marekw1986/HD64180_computer/code/CPMBootloader/README.md

# POLON 7880

This is code of TinyBsic for final version of POLON 7880, build on PCBs.
