marekw1986/HD64180_computer/hardware/cpu_board/untitled.brd

## EAGLE design hardware/cpu_board/untitled.brd (2026-01-10)

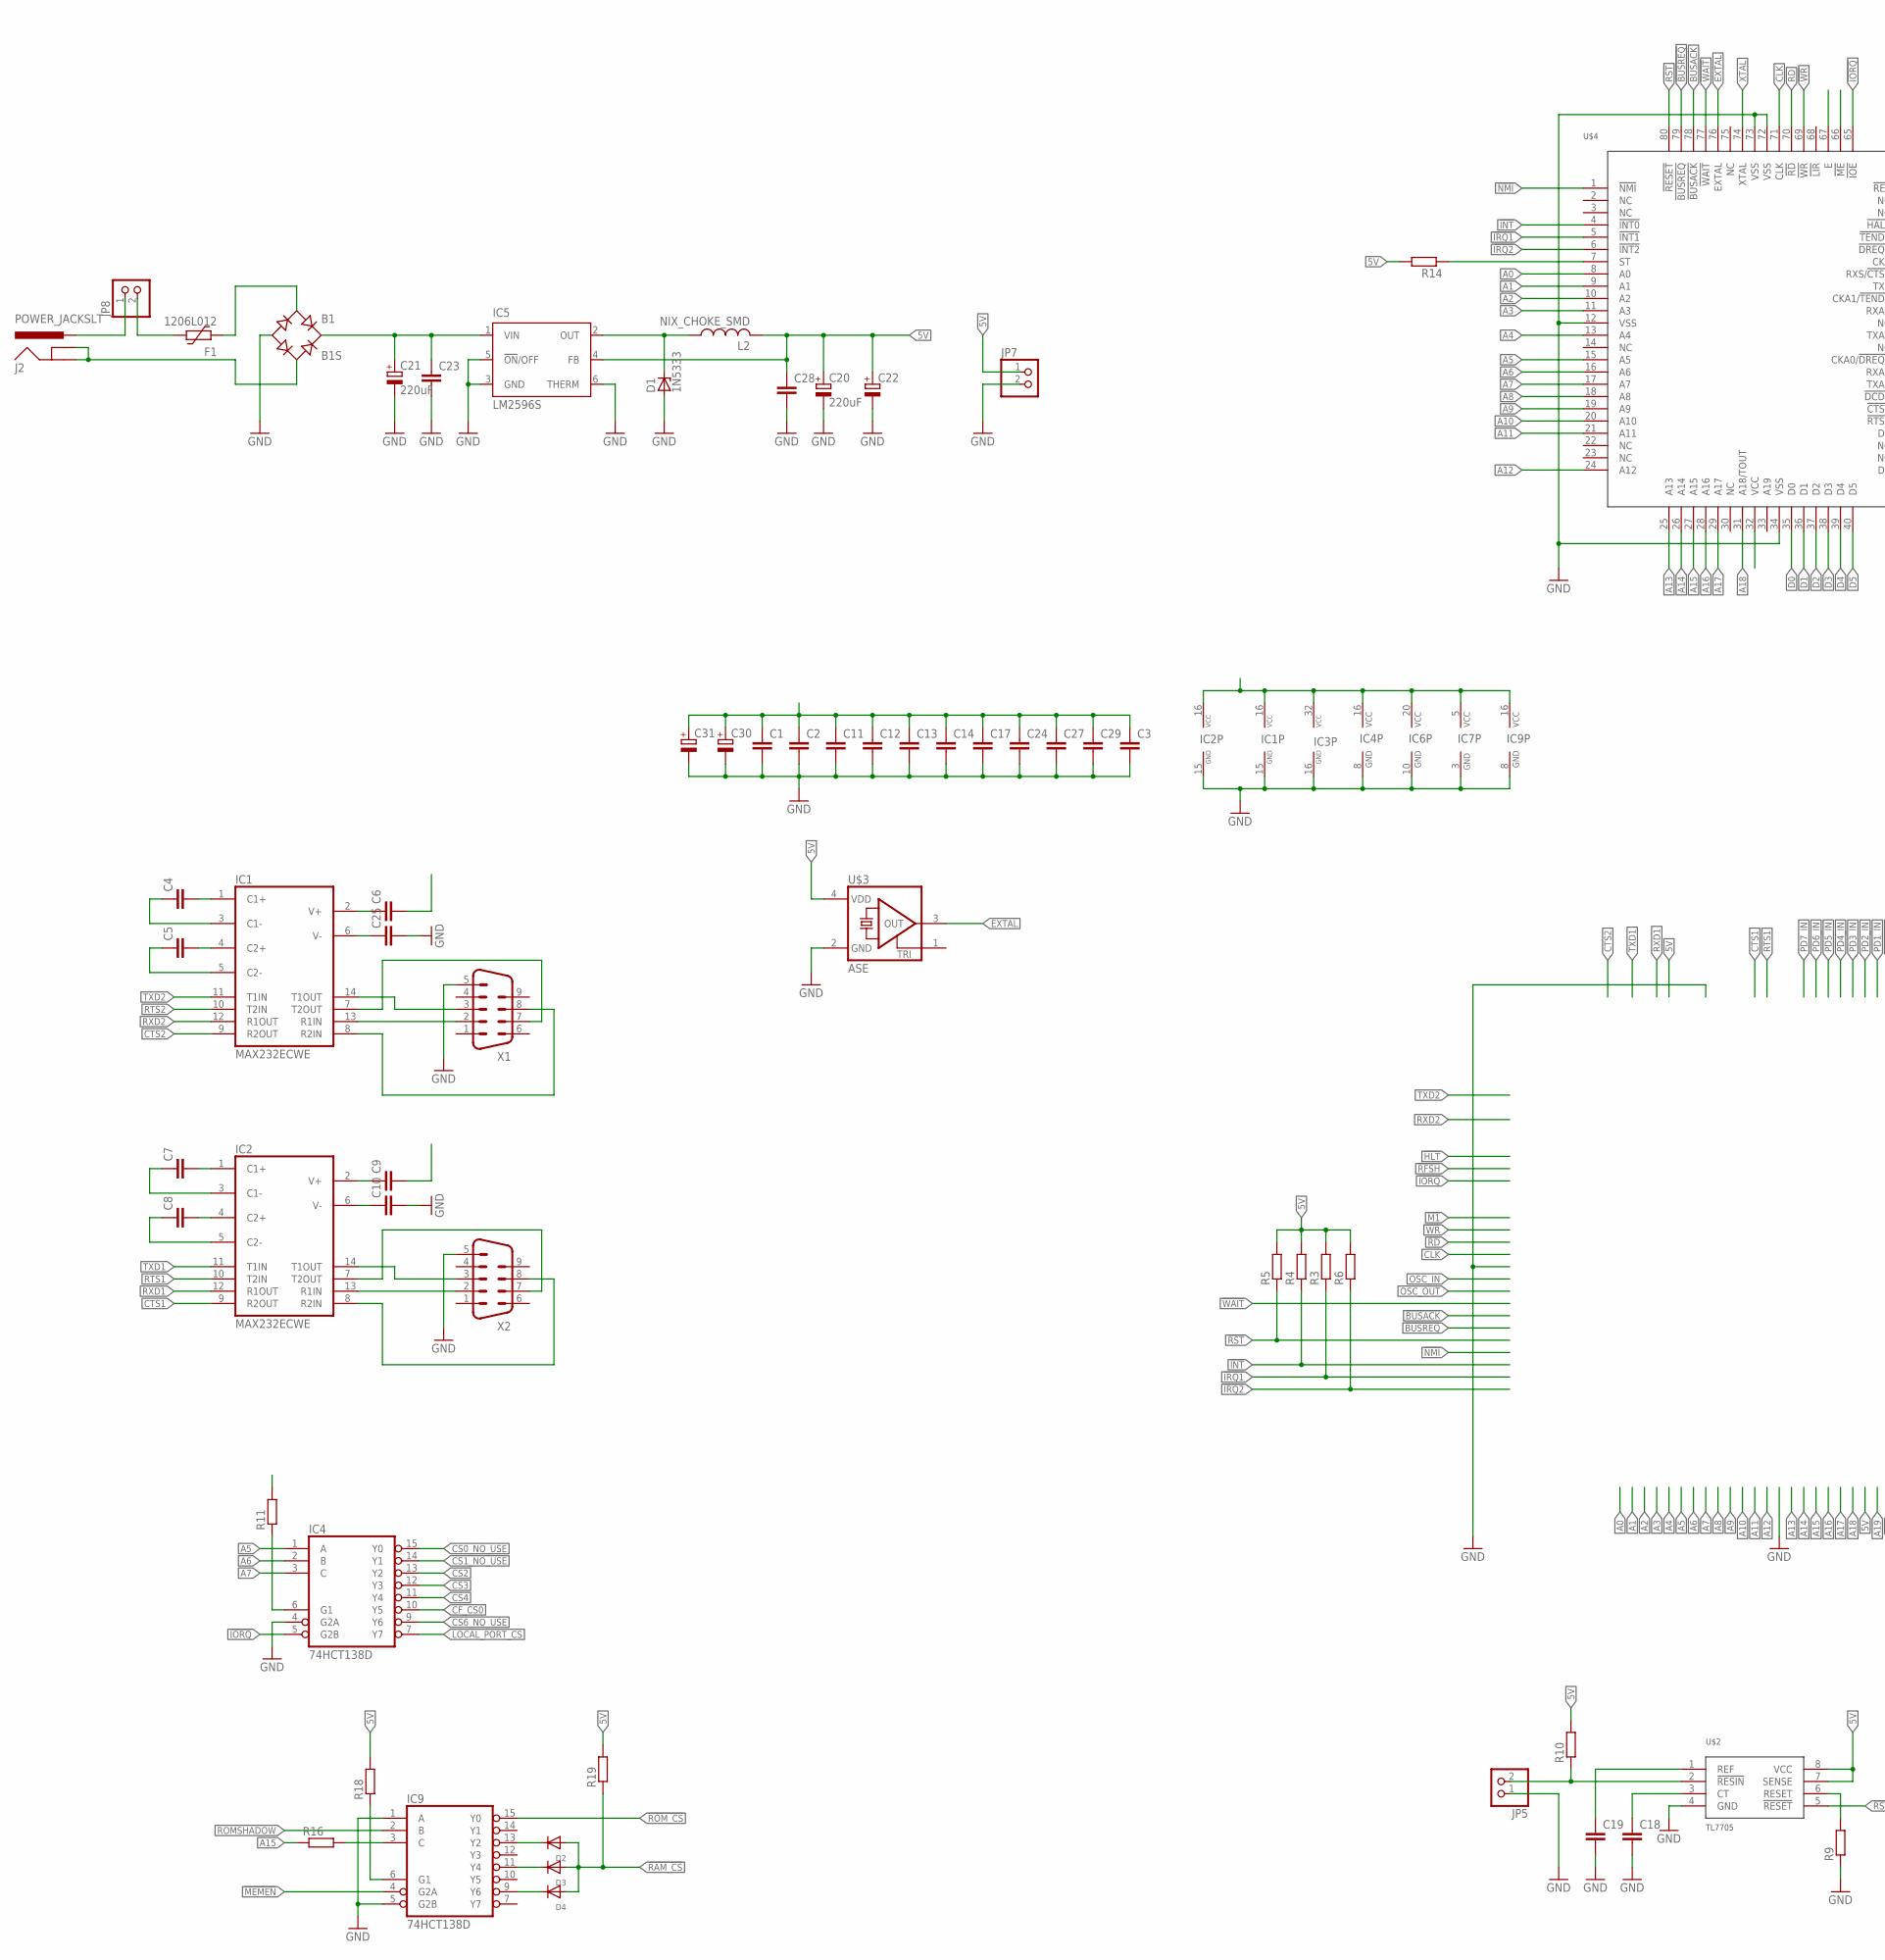
[picture p1: schematic untitled.sch, part in row 1, column 1]

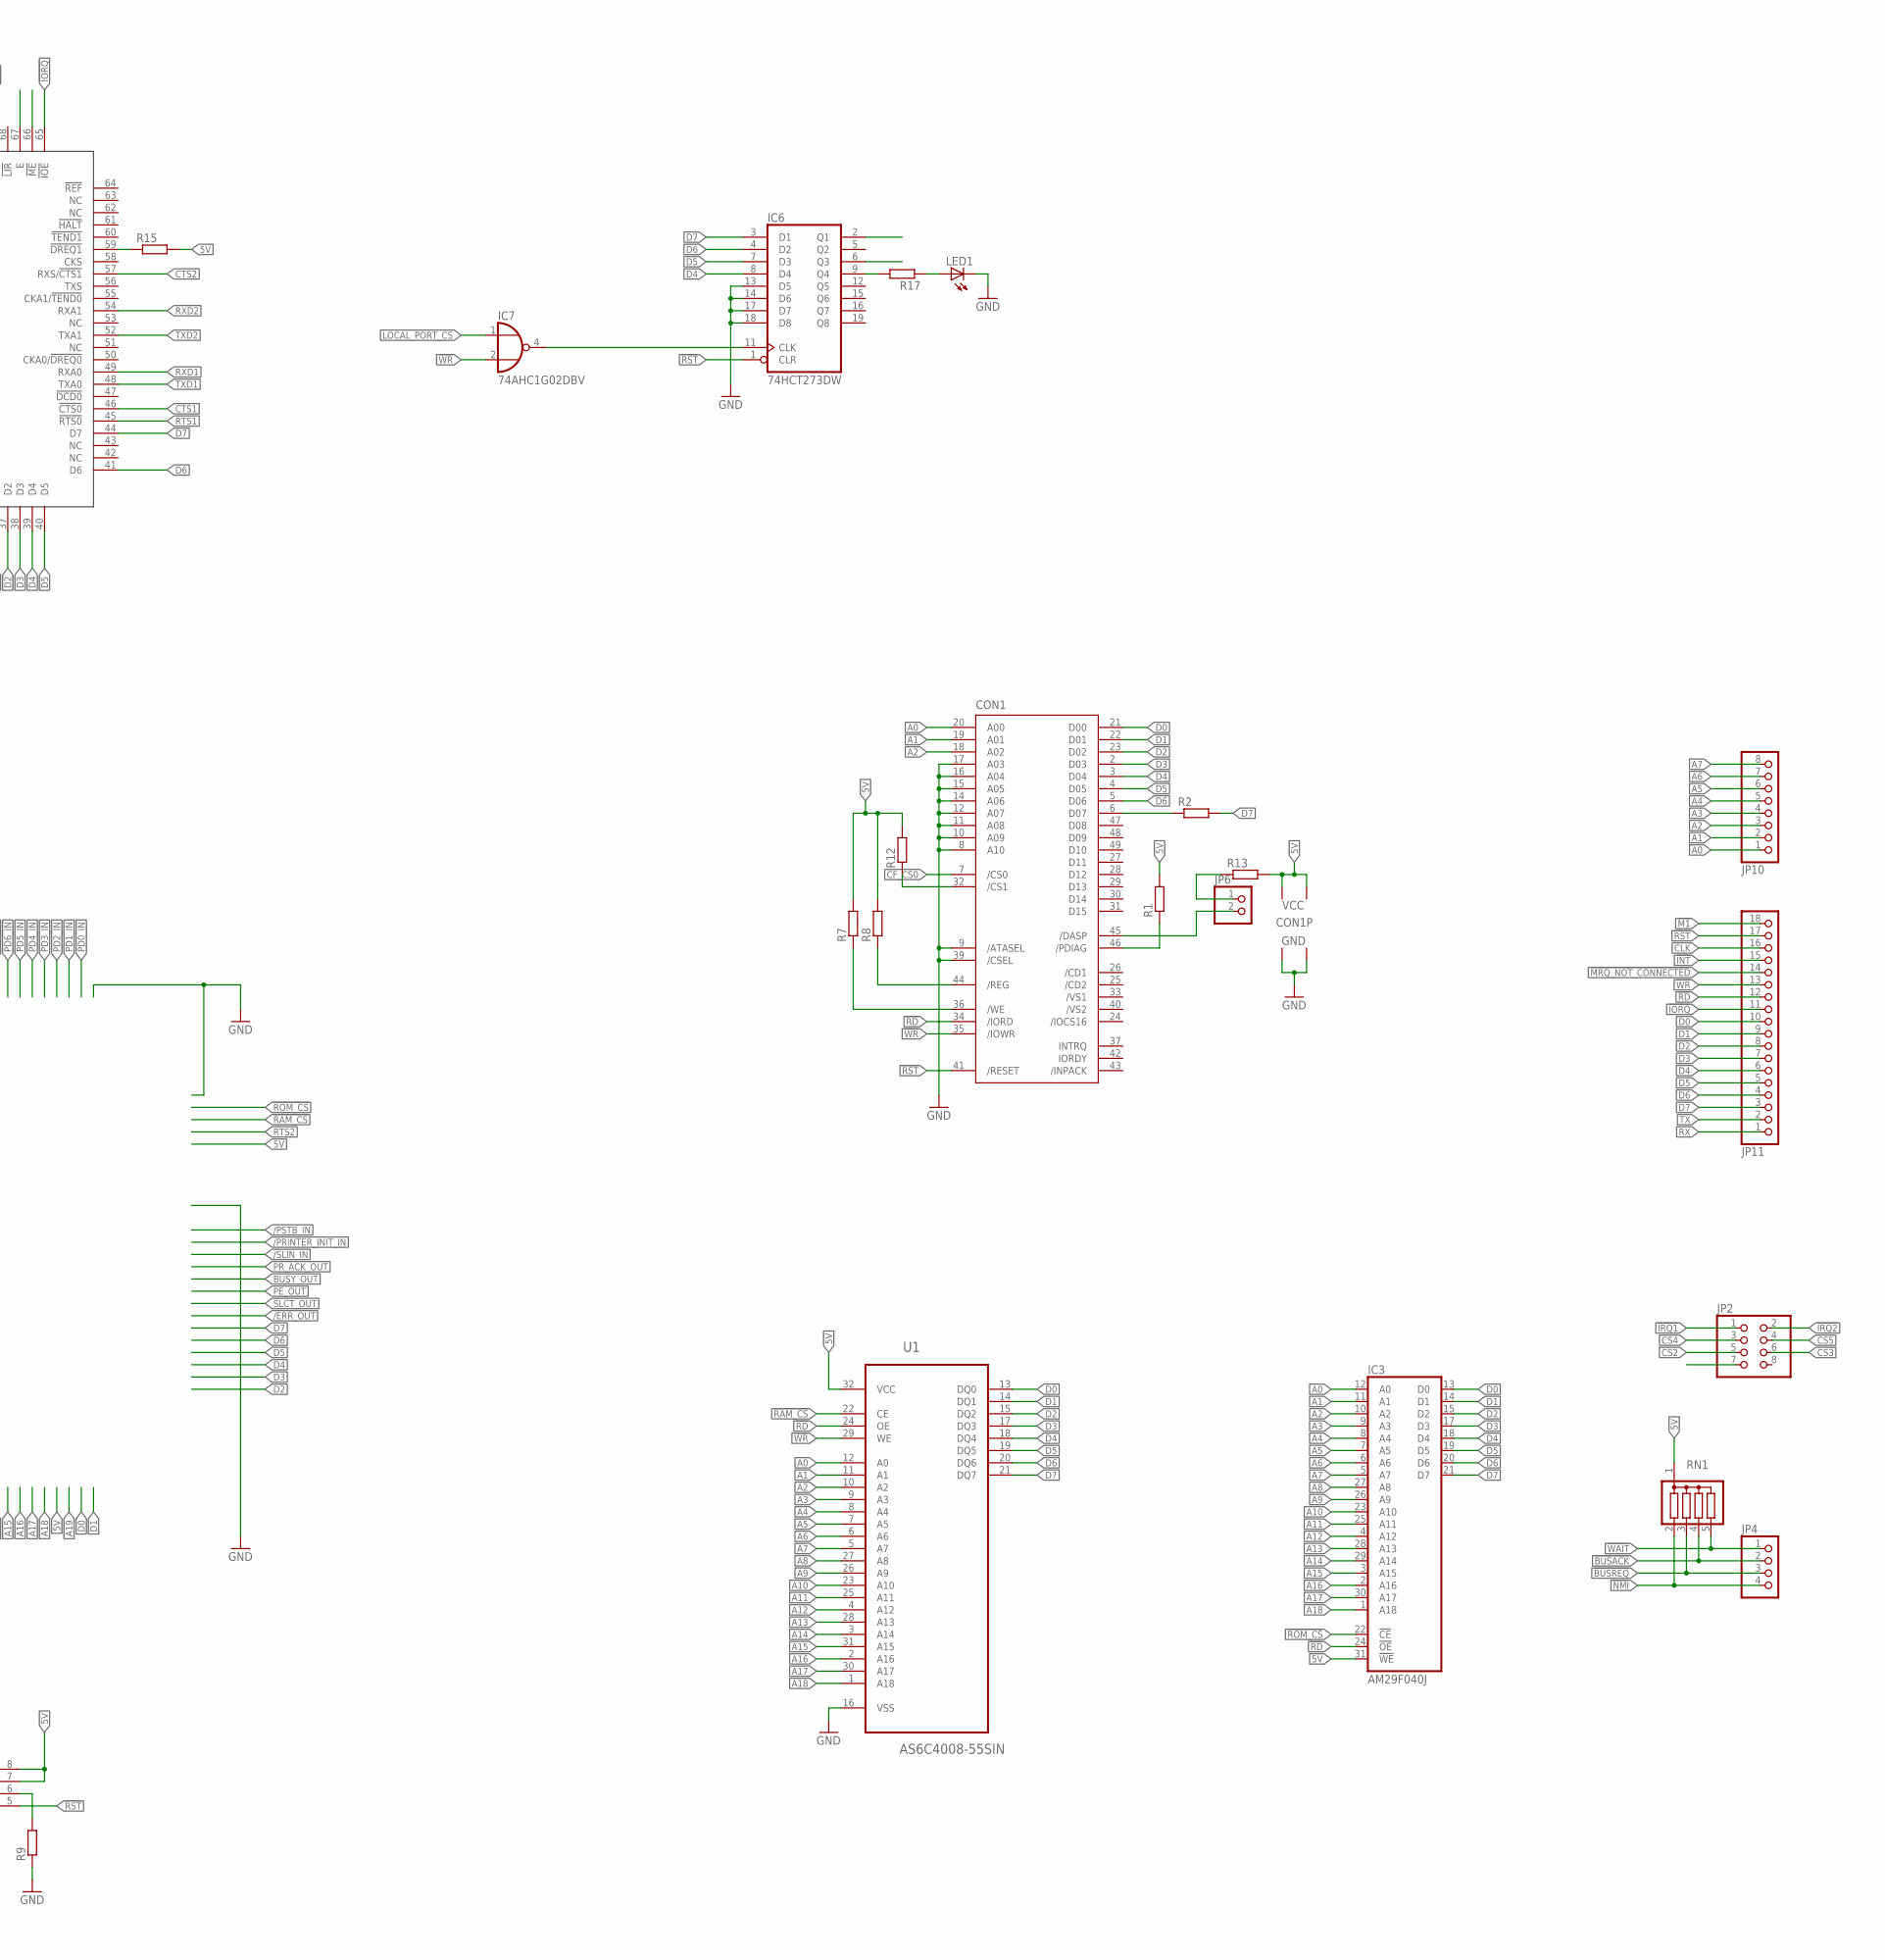
[picture p2: schematic untitled.sch, part in row 1, column 2]

Parts:
B1: B1S; MBS
C1, C2, C3, C4, C5, C6, C7, C8, C9, C10, C11, C12, C14, C17, C18, C19, C23, C24, C25, C27, C28, C29: C-EUC0603; C0603
C13: C-EUC0402; C0402
C20, C21: 220uF; 153CLV-0810
C22: CPOL-EUSMCC; SMC_C
C30, C31: CPOL-EUSMCB; SMC_B
CON1: CF-CARD-IDE_MODE; MI20-50PD-SF
D1: 1N5333; C1702-15
D2, D3, D4: DIODESOD-323; SOD-323
F1: 1206L012; 1206L
IC1, IC2: MAX232ECWE; SO16L
IC3: AM29F040J; PLCC32R
IC4, IC9: 74HCT138D; SO16
IC5: LM2596S; TO263-5
IC6: 74HCT273DW; SO20W
IC7: 74AHC1G02DBV; SOT23-5
J2: POWER_JACKSLT; POWER_JACK_SLOT
JP2: PINHD-2X4; 2X04
JP4: PINHD-1X4; 1X04
JP5, JP6, JP7, JP8: PINHD-1X2; 1X02
JP10: PINHD-1X8; 1X08
JP11: PINHD-1X18; 1X18
L2: NIX_CHOKE_SMD
LED1: LEDCHIP-LED0603; CHIP-LED0603
R1, R2, R7, R8, R9, R11, R12, R13, R15, R16, R17, R18, R19: R-EU_R0603; R0603
R3, R4, R6: R-EU_R0402; R0402
R5: R-EU_R1206; R1206
R10: R-EU_M1206; M1206
R14: R-EU_0204/5; 0204/5
RN1: G04R; SIL5
U1: AS6C4008-55SIN; SOIC127P1407X299-32N
U$2: TL7705; SOIC8
U$3: ASE
U$4: HD64180QFP80_; QFP80
X1, X2: M09HP

Connections:
5V: C1.1, C2.1, C3.1, C6.2, C9.2, C11.1, C12.1, C13.1, C14.1, C17.1, C20.+, C22.+, C24.1, C27.1, C28.1, C29.1, C30.+, C31.+, CON1.13 (VCC2), CON1.38 (VCC1), IC1.16 (VCC), IC2.16 (VCC), IC3.31 (!WE), IC3.32 (VCC), IC4.16 (VCC), IC5.4 (FB), IC6.20 (VCC), IC7.5 (VCC), IC9.16 (VCC), JP7.1, L2.P$2 (2), R1.2, R3.2, R4.2, R5.2, R6.2, R7.2, R8.2, R10.2, R11.2, R12.2, R13.2, R14.2, R15.2, R18.2, R19.2, RN1.1, U1.32 (VCC), U$2.7 (SENSE), U$2.8 (VCC), U$3.4 (VDD), U$4.32 (VCC)
!BUSACK: JP4.2, RN1.4, U$4.78 (!BUSACK)
!BUSREQ: JP4.3, RN1.3, U$4.79 (!BUSREQ)
!INT: JP11.15, R4.1, U$4.4 (!INT0)
!IORQ: IC4.5 (G2B), JP11.11, U$4.65 (!IOE)
!IRQ1: JP2.1, R3.1, U$4.5 (!INT1)
!IRQ2: JP2.2, R6.1, U$4.6 (!INT2)
!M1: JP11.18
!MEMEN: IC9.4 (G2A), U$4.66 (!ME)
!MRQ_NOT_CONNECTED: JP11.14
!NMI: JP4.4, RN1.2, U$4.1 (!NMI)
!RAM_CS: D2.A, D3.A, D4.A, R19.1, U1.22 (CE)
!RD: CON1.34 (/IORD), IC3.24 (!OE), JP11.12, U1.24 (OE), U$4.70 (!RD)
!ROM_CS: IC3.22 (!CE), IC9.15 (Y0)
!RST: CON1.41 (/RESET), IC6.1 (CLR), JP11.17, R5.1, U$2.5 (!RESET), U$4.80 (!RESET)
!WAIT: JP4.1, RN1.5, U$4.77 (!WAIT)
!WR: CON1.35 (/IOWR), IC7.2 (I1), JP11.13, U1.29 (WE), U$4.69 (!WR)
A0: CON1.20 (A00), IC3.12 (A0), JP10.1, U1.12 (A0), U$4.8 (A0)
A1: CON1.19 (A01), IC3.11 (A1), JP10.2, U1.11 (A1), U$4.9 (A1)
A2: CON1.18 (A02), IC3.10 (A2), JP10.3, U1.10 (A2), U$4.10 (A2)
A3: IC3.9 (A3), JP10.4, U1.9 (A3), U$4.11 (A3)
A4: IC3.8 (A4), JP10.5, U1.8 (A4), U$4.13 (A4)
A5: IC3.7 (A5), IC4.1 (A), JP10.6, U1.7 (A5), U$4.15 (A5)
A6: IC3.6 (A6), IC4.2 (B), JP10.7, U1.6 (A6), U$4.16 (A6)
A7: IC3.5 (A7), IC4.3 (C), JP10.8, U1.5 (A7), U$4.17 (A7)
A8: IC3.27 (A8), U1.27 (A8), U$4.18 (A8)
A9: IC3.26 (A9), U1.26 (A9), U$4.19 (A9)
A10: IC3.23 (A10), U1.23 (A10), U$4.20 (A10)
A11: IC3.25 (A11), U1.25 (A11), U$4.21 (A11)
A12: IC3.4 (A12), U1.4 (A12), U$4.24 (A12)
A13: IC3.28 (A13), U1.28 (A13), U$4.25 (A13)
A14: IC3.29 (A14), U1.3 (A14), U$4.26 (A14)
A15: IC3.3 (A15), R16.1, U1.31 (A15), U$4.27 (A15)
A16: IC3.2 (A16), U1.2 (A16), U$4.28 (A16)
A17: IC3.30 (A17), U1.30 (A17), U$4.29 (A17)
A18: IC3.1 (A18), U1.1 (A18), U$4.31 (A18/TOUT)
CF_CS0: CON1.7 (/CS0), IC4.10 (Y5)
CLK: JP11.16, U$4.71 (CLK)
CS0_NO_USE: IC4.15 (Y0)
CS1_NO_USE: IC4.14 (Y1)
CS2: IC4.13 (Y2), JP2.5
CS3: IC4.12 (Y3), JP2.6
CS4: IC4.11 (Y4), JP2.3
CS5: JP2.4
CS6_NO_USE: IC4.9 (Y6)
CTS1: IC2.9 (R2OUT), U$4.46 (!CTS0)
CTS2: IC1.9 (R2OUT), U$4.57 (RXS/!CTS1)
D0: CON1.21 (D00), IC3.13 (D0), JP11.10, U1.13 (DQ0), U$4.35 (D0)
D1: CON1.22 (D01), IC3.14 (D1), JP11.9, U1.14 (DQ1), U$4.36 (D1)
D2: CON1.23 (D02), IC3.15 (D2), JP11.8, U1.15 (DQ2), U$4.37 (D2)
D3: CON1.2 (D03), IC3.17 (D3), JP11.7, U1.17 (DQ3), U$4.38 (D3)
D4: CON1.3 (D04), IC3.18 (D4), IC6.8 (D4), JP11.6, U1.18 (DQ4), U$4.39 (D4)
D5: CON1.4 (D05), IC3.19 (D5), IC6.7 (D3), JP11.5, U1.19 (DQ5), U$4.40 (D5)
D6: CON1.5 (D06), IC3.20 (D6), IC6.4 (D2), JP11.4, U1.20 (DQ6), U$4.41 (D6)
D7: IC3.21 (D7), IC6.3 (D1), JP11.3, R2.2, U1.21 (DQ7), U$4.44 (D7)
E: JP2.7, U$4.67 (E)
EXTAL: U$3.3 (OUT), U$4.76 (EXTAL)
GND: B1.-, C1.2, C2.2, C3.2, C10.2, C11.2, C12.2, C13.2, C14.2, C17.2, C18.2, C19.2, C20.-, C21.-, C22.-, C23.2, C24.2, C25.2, C27.2, C28.2, C29.2, C30.-, C31.-, CON1.1 (GND1), CON1.8 (A10), CON1.9 (/ATASEL), CON1.10 (A09), CON1.11 (A08), CON1.12 (A07), CON1.14 (A06), CON1.15 (A05), CON1.16 (A04), CON1.17 (A03), CON1.39 (/CSEL), CON1.50 (GND2), D1.A, IC1.15 (GND), IC2.15 (GND), IC3.16 (GND), IC4.4 (G2A), IC4.8 (GND), IC5.3 (GND), IC5.5 (!ON!/OFF), IC5.6 (THERM), IC6.10 (GND), IC6.13 (D5), IC6.14 (D6), IC6.17 (D7), IC6.18 (D8), IC7.3 (GND), IC9.1 (A), IC9.5 (G2B), IC9.8 (GND), JP5.1, JP7.2, LED1.C, R9.1, U1.16 (VSS), U$2.4 (GND), U$3.2 (GND), U$4.12 (VSS), U$4.34 (VSS), U$4.72 (VSS), U$4.73 (VSS), X1.5, X2.5
LOCAL_PORT_CS: IC4.7 (Y7), IC7.1 (I0)
unnamed: IC2.7 (T2OUT), X2.7
unnamed: C7.2, IC2.1 (C1+)
unnamed: C8.2, IC2.4 (C2+)
unnamed: C8.1, IC2.5 (C2-)
unnamed: C7.1, IC2.3 (C1-)
unnamed: C9.1, IC2.2 (V+)
unnamed: IC1.7 (T2OUT), X1.7
unnamed: IC1.13 (R1IN), X1.2
unnamed: C4.2, IC1.1 (C1+)
unnamed: C5.2, IC1.4 (C2+)
unnamed: C5.1, IC1.5 (C2-)
unnamed: C4.1, IC1.3 (C1-)
unnamed: C6.1, IC1.2 (V+)
unnamed: C25.1, IC1.6 (V-)
unnamed: IC2.13 (R1IN), X2.2
unnamed: IC2.14 (T1OUT), X2.3
unnamed: IC2.8 (R2IN), X2.8
unnamed: IC1.14 (T1OUT), X1.3
unnamed: C10.1, IC2.6 (V-)
unnamed: J2.PWR, JP8.1
unnamed: B1.AC1, F1.2
unnamed: B1.+, C21.+, C23.1, IC5.1 (VIN)
unnamed: D1.C, IC5.2 (OUT), L2.P$1 (1)
unnamed: B1.AC2, J2.GND@1 (GNDBREAK), J2.GND@2 (GND)
unnamed: R15.1, U$4.59 (!DREQ1)
unnamed: IC4.6 (G1), R11.1
unnamed: CON1.44 (/REG), R8.1
unnamed: IC1.8 (R2IN), X1.8
unnamed: CON1.36 (/WE), R7.1
unnamed: CON1.46 (/PDIAG), R1.1
unnamed: CON1.32 (/CS1), R12.1
unnamed: JP6.1, R13.1
unnamed: CON1.45 (/DASP), JP6.2
unnamed: CON1.6 (D07), R2.1
unnamed: R9.2, U$2.6 (RESET)
unnamed: C18.1, U$2.3 (CT)
unnamed: C19.1, U$2.1 (REF)
unnamed: JP5.2, R10.1, U$2.2 (!RESIN)
unnamed: F1.1, JP8.2
unnamed: IC6.11 (CLK), IC7.4 (O)
unnamed: IC6.9 (Q4), R17.2
unnamed: LED1.A, R17.1
unnamed: IC9.6 (G1), R18.1
unnamed: D2.C, IC9.13 (Y2)
unnamed: D4.C, IC9.9 (Y6)
unnamed: D3.C, IC9.11 (Y4)
ROMSHADOW: IC6.6 (Q3), IC9.2 (B)
RTS1: IC2.10 (T2IN), U$4.45 (!RTS0)
RTS2: IC1.10 (T2IN), IC6.2 (Q1)
RX: JP11.1
RXD1: IC2.12 (R1OUT), U$4.49 (RXA0)
RXD2: IC1.12 (R1OUT), U$4.54 (RXA1)
ST: R14.1, U$4.7 (ST)
TX: JP11.2
TXD1: IC2.11 (T1IN), U$4.48 (TXA0)
TXD2: IC1.11 (T1IN), U$4.52 (TXA1)
XTAL: U$4.74 (XTAL)
_A15: IC9.3 (C), R16.2

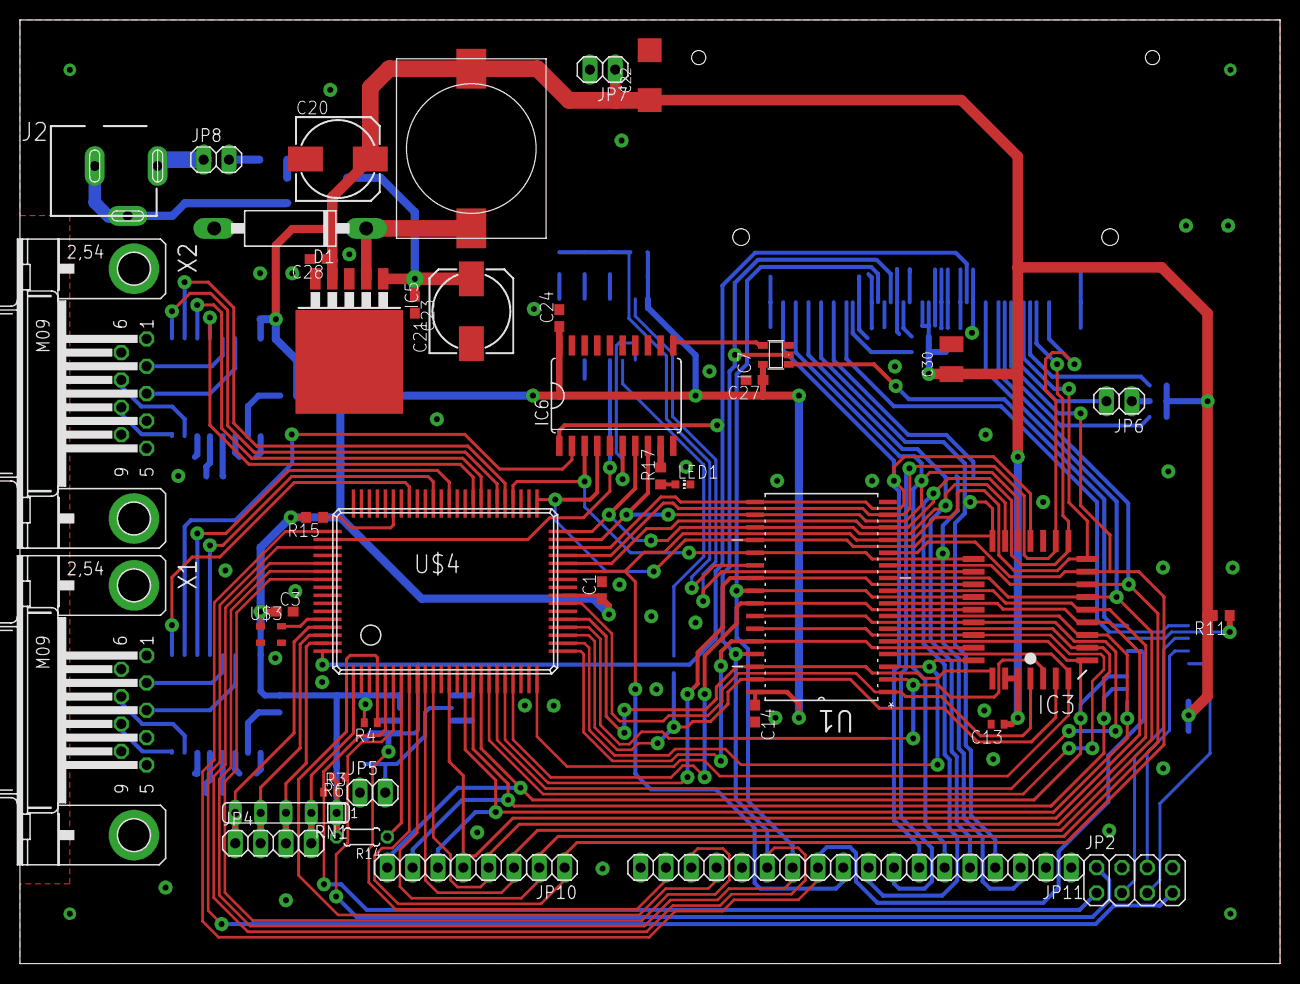
[picture p3: board untitled.brd from above]

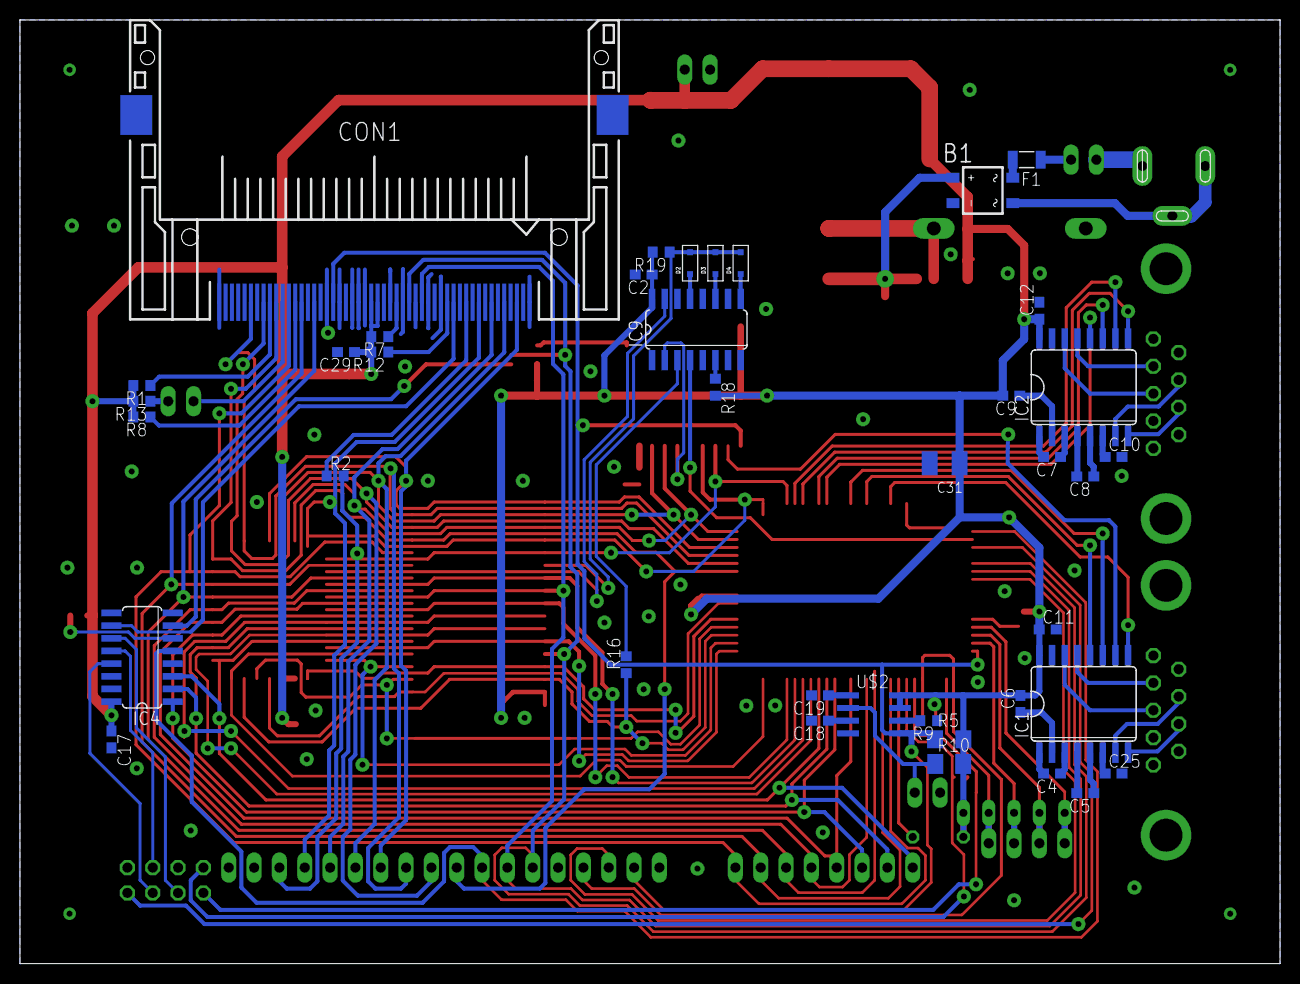
[picture p4: board untitled.brd from below]

Board: 2 copper layers, 126.3 x 94.6 mm, 80 parts (39 on the bottom side), 108 nets.
