marekw1986/HD64180_computer/(commit log)

2025-10-06 PCB update
    [untitled.brd, untitled.sch]
2025-10-07 PCB updated
    [untitled.brd, untitled.sch]
2025-10-07 Minor update
    [untitled.brd]
2025-10-08 Data lines routed
    [untitled.brd]
2025-10-08 Another update
    [untitled.brd]
2025-10-08 Local port added
    [untitled.brd, untitled.sch]
2025-10-08 E signal routed to edge connector
    [untitled.brd, untitled.sch]
2025-10-08 Memory address decoder (work in progress)
    [untitled.brd, untitled.sch]
2025-10-08 Minor changes
    [untitled.brd, untitled.sch]
2025-10-08 Minor change
    [untitled.brd]
2025-10-08 VCC rerouted
    [untitled.brd]
2025-10-08 Writing to 273 fixed
    [untitled.brd, untitled.sch]
2025-10-09 RAM/ROM address decoder (work in progress)
    [untitled.brd, untitled.sch]
2025-10-09 ROM/RAM address decoder (version with diodes and wired-or on RAMCS line)
    [untitled.brd, untitled.sch]
2025-10-09 Mionor bug fixed
    [untitled.brd]
2025-10-09 ROM/RAM address decoder bug fix
    [untitled.brd, untitled.sch]
2025-10-09 Capacitor added
    [untitled.brd, untitled.sch]
2025-10-12 UART test added
2025-10-24 CPU size fixed
    [untitled.brd, untitled.sch]
2025-11-10 Minor PCB update
    [untitled.brd]
2025-11-13 Cutout added to avoid accidental shoring of DB9 sockets shield to board ground
    [untitled.brd]
2026-01-10 PCB bug fix
    [untitled.brd, untitled.sch]
2026-01-19 UART test code works now
2026-02-25 proper uart setting in uart_test
2026-02-25 Proper UART configuration for CP/M bootloader
2026-02-25 Bug fixed in CP/M BIOS uart driver
    [utils_z180.asm]
